leonprietobailo/DroneSTM32F405/doc/schemes.pptx

Batería

PDB

Sensores
(IMU, BMP280…)

Microcontrolador

ESCs

Motores

Receptor RC

## Slide 2

Inicialización

Instanciación variables globales

Inicialización software

Bucle principal

Cálculo referencia

Lectura y procesado sensores

Controladores

Actuadores

## Slide 3

Inicialización

Instanciación variables globales

Inicialización software

init_flash()

init_led()

Bucle principal

Cálculo referencia

Lectura y procesado sensores

Controladores

Actuadores

init_ultrasonic()

init_rc()

init_esc()

init_imu()

init_barometer()

## Slide 4

Inicialización

Instanciación variables globales

Inicialización software

Bucle principal

Cálculo referencia

Lectura y procesado sensores

Controladores

Actuadores

ref_mode_management()

ref_gen()

## Slide 5

Inicialización

Instanciación variables globales

Inicialización software

Bucle principal

Cálculo referencia

Lectura y procesado sensores

Controladores

Actuadores

read_battery()

read_rc()

red_imu()

process_imu()

read_barometer()

## Slide 6

Inicialización

Instanciación variables globales

Inicialización software

Bucle principal

Cálculo referencia

Lectura y procesado sensores

Controladores

Actuadores

cnt_attitude_sp()

cnt_attitude_pid()

cnt_altitude_pid()

## Slide 7

Inicialización

Instanciación variables globales

Inicialización software

Bucle principal

Cálculo referencia

Lectura y procesado sensores

Controladores

Actuadores

act_esc_outputs()

act_esc_pwm()

act_us_pulse()

## Slide 8

Espera

Espera

Espera

Solicitud y lectura

Espera

Lectura

Solicitud

Espera

## Slide 9

Duración ciclo > 4000 µs

Ejecución ciclo

Sí

No

## Slide 10

Stabilized

Disabled

Mounting

Altitude Hold
