leonprietobailo/DroneSTM32F405/SPI_flash/SdFat_print_file/SdFat_print_file.ino

// Adafruit SPI Flash FatFs Simple Datalogging Example
// Author: Tony DiCola
//
// This is a simple example that opens a file and prints its
// entire contents to the serial monitor.  Note that
// you MUST have a flash chip that's formatted with a flash
// filesystem before running, and there should be some sort
// of text file on it to open and read.  See the fatfs_format
// example to perform this formatting, and the fatfs_datalogging
// example to write a simple text file.
//
// Usage:
// - Modify the pins and type of fatfs object in the config
//   section below if necessary (usually not necessary).
// - Upload this sketch to your M0 express board.
// - Open the serial monitor at 115200 baud.  You should see the
//   example start to run and messages printed to the monitor.
//   If you don't see anything close the serial monitor, press
//   the board reset buttton, wait a few seconds, then open the
//   serial monitor again.

#include <SPI.h>
#include <SdFat.h>
#include <Adafruit_SPIFlash.h>

// for flashTransport definition
SPIClass SPI_FLASH(PIN_SPI3_MOSI, PIN_SPI3_MISO, PIN_SPI3_SCK, PIN_SPI3_SS);
Adafruit_FlashTransport_SPI flashTransport(PIN_SPI3_SS, &SPI_FLASH);

Adafruit_SPIFlash flash(&flashTransport);

// file system object from SdFat
FatVolume fatfs;

// Configuration for the file to open and read:
#define FILE_NAME      "data.csv"

void setup() {
  // Initialize serial port and wait for it to open before continuing.
  Serial.begin(115200);
  while (!Serial) {
    delay(100);
  }
  Serial.println("Adafruit SPI Flash FatFs Simple File Printing Example");

  // Initialize flash library and check its chip ID.
  if (!flash.begin()) {
    Serial.println("Error, failed to initialize flash chip!");
    while(1) delay(1);
  }
  Serial.print("Flash chip JEDEC ID: 0x"); Serial.println(flash.getJEDECID(), HEX);

  // First call begin to mount the filesystem.  Check that it returns true
  // to make sure the filesystem was mounted.
  if (!fatfs.begin(&flash)) {
    Serial.println("Error, failed to mount newly formatted filesystem!");
    Serial.println("Was the flash chip formatted with the fatfs_format example?");
    while(1) delay(1);
  }
  Serial.println("Mounted filesystem!");

  // Open the file for reading and check that it was successfully opened.
  // The FILE_READ mode will open the file for reading.
  File32 dataFile = fatfs.open(FILE_NAME, FILE_READ);
  if (dataFile) {
    // File was opened, now print out data character by character until at the
    // end of the file.
    Serial.println("Opened file, printing contents below:");
    while (dataFile.available()) {
      // Use the read function to read the next character.
      // You can alternatively use other functions like readUntil, readString, etc.
      // See the fatfs_full_usage example for more details.
      char c = dataFile.read();
      Serial.print(c);
    }
  }
  else {
    Serial.print("Failed to open file \"");
    Serial.print(FILE_NAME);
    Serial.print("\" !! Does it exist?");
  }
  Serial.println("done");
}

void loop() {
  // Nothing to do in main loop.
  delay(100);
}
