leonprietobailo/DroneSTM32F405/(commit log)

2022-07-23 [First Version] Template code from Joop Brokking downloaded from: http://www.brokking.net/ymfc-32_downloads.html To be adapted for the Feather STM32F405 chip.
2022-07-23 Modified XXXX_BASE with XXXX due to discrpancies between STM32F103C8T6 and STM32F405 definitions. Partly replaced HWire objects to Wire objects, this is because "Wire.h" now includes "HardWire.h" lib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
    TO BE CHECKED: Line 31 and 59 commented out of YMFC-32_Setup_ver-1a.ino, the imact of these changes has not been checked yet.
    [YMFC-32_Setup_ver-1a.ino, check_motor_vibrations.ino, input_capture_mode_handlers.ino, timer_setup.ino]
2022-08-04 Changed handlers and how interrupts are done in line with www.arduproject.es, performance to be checked. (timer_setup.ino, input_capture_mode_handlers.ino)
    Added PIN definition for Throttle, Yaw, Pitch and Roll. YMFC-32_Setup_ver-1a.ino
2022-09-12 gyro_setup.ino, read_gyro_data.ino: Modified HWire with Wire library
    input_capture_mode_handlers.ino: Modified handlers in line with YMFC-32_Setup_ver-1a/input_capture_mode_handlers.ino
    timer_setup.ino: Modified interrupts in line with YMFC-32_Setup_ver-1a/timer_setup.ino
    YMFC-32_Flight_Controller_ver-1a.ino: Added *hardcoded* calibrated radio values (check radioCallib/radioCallib.ino), added pins for radio commands.
2022-11-29 Added LED controls and general strength to the code in order to avoid drone getting crazy.
2022-11-30 Commented out timer_setup.ino lines corresponding with transmitter availability.
    Modified PID controller: YMFC-32_Flight_Controller_ver-1a.ino
2022-12-01 Modified read_gyro_data.ino to correct orrientation issues
    Modified radio calibration values on YMFC-32_Flight_Controller_ver-1a.ino
2022-12-05 Adjusted PID settings. Added proper commenting for troubleshooting.
2022-12-13 Added measure_distance.ino: this file computes distance using the ultrasonic sensor based on interrupts.
    Commented out error_signal.ino.
    Modified LED_control.ino: added fast and slow blinking LED and functions to turn on and off LED.
    YMFC-32_Flight_Controller_ver-1a.ino: modified LED functions in line with LED_control.ino changes. Added the corresponding setup and call of measure_distance.ino.
    [input_capture_mode_handlers.ino]
2022-12-14 measure_distance.ino: Added function for ultrasonic control. Added autolanding behaviour.
    YMFC-32_Flight_Controller_ver-1a.ino: added calls for measure_distance.ino functions
2022-12-16 measure_distance.ino: modified ultrasonic correction function
2022-12-23 timer_setup.ino: Was only being used for setup purposes, moved lines to YMFC-32_Flight_Controller_ver-1a.ino.
    measure_distance.ino: added ultrasonic correction functions (does not work atm), added velocity signal generation on echoPin_trigger()
    input_capture_mode_handlers.ino: commented out single channel interrupt handlers. Added read_PPM() which reads PPM signals (interrupt call). Added read_RC() which processes RC signals.
    YMFC-32_Flight_Controller_ver-1a.ino: Added SD card writing lines. Removed definitions for old RC pins, added the corresponding one for PPM. Added setup from timer_setup.ino and removed it's call. Modified all channel_x with the vectorised Mando_canal[x]. Added read_R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
    [input_capture_mode_handlers.ino, timer_setup.ino]
2022-12-27 input_capture_mode_handlers.ino: Renamed into read_rc.ino. Removed old comented handlers.
    process_rc.ino: Added new file for RC related commands.
    YMFC-32_Flight_Controller_ver-1a/YMFC-32_Flight_Controller_ver-1a.ino: Added acceleration related variables for auto-takeoff. Added call for newly added process_rc.ino function. Moved to process_rc.ino the RC related commands. Added new throttle computation (using takeoff throttle).
2022-12-27 process_rc.ino: Removed autonomous takeoff
    YMFC-32_Flight_Controller_ver-1a.ino: Reverted #Revision17 throttle computation.
2023-01-02 calculate_pid.ino: Added PID attitude control
    YMFC-32_Flight_Controller_ver-1a.ino: Added attitude control PID variables, added switch for throttle control. (UP: Normal control, DOWN: Attitude control)
2023-01-02 calculate_pid.ino: Splitted attitude control PIDs and altitude control PID.
    YMFC-32_Flight_Controller_ver-1a.ino: Modified hover lift hardcoded value. Added call to altitude_pid function.
2023-01-02 battery_control.ino: Added file to perform battery voltage computations and buzzer alarms.
    YMFC-32_Flight_Controller_ver-1a.ino: Added battery_control.ino initialisation.
2023-01-03 Added Joop Brokking code for STM32 - Auto.
2023-01-12 calculate_pid.ino: Added derivative outputs.
    YMFC-32_Flight_Controller_ver-1a/YMFC-32_Flight_Controller_ver-1a.ino: Added initializations, reduced reference hover throttle to 1450.
    process_gps.ino: Added GPS signal processing.
2023-01-15 calculate_pid.ino: Modified setpoint from 45 cm to 30 cm.
    YMFC-32_Flight_Controller_ver-1a.ino: Modified altitude hold PID variables, added integrator and derivator resets for altitude control PIDs.
2023-01-16 calculate_pid.ino: Added linearly increasing proportional gain.
    measure_distance.ino: Added filter for ultrasonic received measurements over 200 cm. (Not needed)
2023-01-16 calculate_pid.ino: Reverted to constant P gain.
    YMFC-32_Flight_Controller_ver-1a.ino: Tuned altitude hold controller, modified hover throttle value.
2023-01-18 battery_control.ino: Modified buzzer function.
    YMFC-32_Flight_Controller_ver-1a.ino: Added call to battery control fcn, modified how battery voltage is measured.
2023-01-18 battery_control.ino: Modified battery control values.
    YMFC-32_Flight_Controller_ver-1a.ino: Modified hover throttle.
2023-01-19 YMFC-32_Flight_Controller_ver-1a.ino: Removed yaw integrator. Added hover throttle computation to be battery voltage dependant.
2023-01-19 YMFC-32_Flight_Controller_ver-1a.ino: Modified hover throttle value, modified P gain for altitude control.
2023-01-19 calculate_pid.ino: modified setpoint, modified increasing p gain.
    YMFC-32_Flight_Controller_ver-1a.ino: modified hover throttle, modified altitude control pid
2023-01-30 Added SPI_flash files for formatting and reading on-board flash memory.
    battery_control.ino: Commented out buzzer sound when low battery is detected.
    calculate_pid.ino: Modified reference altitude, removed increasing proportional gain.
    calibrate_gyro.ino: Added acceleration calibration.
    read_gyro_data.ino: Modified calibration values, added acc_z callibration.
    YMFC-32_Flight_Controller_ver-1a.ino: Added flash storage varaibles for data recording. Added variables for acc calibration, added hover throttle, added flash_setup() call, added flash_write() call.
    compute_hover_throttle.ino: Added compute_hover_throttle.ino function.
    flash_write.ino: Added on.board flash setup and writing.
    [SdFat_print_file.ino, example.ino, format.ino, read.ino]
2023-02-12 calculate_pid.ino: Added integrators again, only triggered when distance is greater than 15 cm, to avoid OL integrator errors.
    measure_distance.ino: Removed complementary filter since it was driving reaction slowness to the drone.
    YMFC-32_Flight_Controller_ver-1a.ino: Removed radio dead bands. Modified origin hoverThrottle. Added variables for integrators and modified PID parameters.
2023-03-20 calculate_pid.ino: Added self adjusting throttle using P controller. ATM. Have not performed any tests.
    Added self adjusting throttle variable declaration + calls.
    Added empty files to change software architecture:
    actuators.ino: Must contain ESCs related computations. E.g.: PWMs...
    controllers.ino: Must contain controller related computations. E.g.: Attitude controllers, altitude hold controller... Will also contain control error computations (probably).
    measurement_processing.ino: Must contain sensor signal related computations: E.g.: Computing current angle, rate...
    reference_computation.ino: Must contain references generated used for PIDs. E.g.: Radio based references, altitude hold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
2023-03-25 Added MS5611/MS5611_base/MS5611_base which contains a working and clean pressure signal obtained from MS5611 sensor ready to be fed to altitude hold controllers.
    Added i2c_scanner/i2c_scanner file which allows address scan for i2c protocols.
    Next step is to implement the sensor to the quadcopter, add the control algorithm and perform adjustments.
2023-03-27 [MAJOR UPDATE]: Changed whole program architecture.
    Now the control algorithm works with the following files:
    actuators.ino: Everything related to actuators: ESCs, ultrasonic...
    controllers.ino: PIDs. In general.
    measurement_processing: Everything related to processing sensor signals.
    read_units: Everything related to sensor readouts.
    Added diganostics.ino file, which provides with useful information regarding diagnostics, this includes buzzer, LEDs or Serial commands.
    Added initialization.ino file, which contain everything related to setup.
    Added z folder which contains tbd and deprecated files.
    [actuators.ino, barometer.ino, controllers.ino, diagnostics.ino, main_YMFC.ino, z_tbd_process_gps.ino]
2023-03-29 Removed self adjusting altitude control throttle.
    Disabled attitude control integrators for small distances.
2023-03-29 LowPass.h: Digital low-pass filter implemented from https://github.com/curiores/ArduinoTutorials/blob/main/BasicFilters/ArduinoImplementations/LowPass/LowPass2.0/LowPass2.0.ino
    actuators.ino: Modified how self adjusting throttle is computed in order to make possible on-air flight mode changes.
    controllers.ino: Modified references, and added new alt_hold_pid following the schematic used for ArduPilot: https://ardupilot.org/copter/docs/altholdmode.html
    main_YMFC.ino: Added required variables in line with latest PID addition.
    read_units.ino: Generated filtered signals in order to perform accurate control.
2023-04-01 controllers.ino: Modified altitude hold controller.
    main_YMFC.ino / read_units.ino: Added new velocity computations + initialization variables.
    BMP280.ino: Generated signal computation, with temperature and pressure corrections. This uses LowPass.h which provides with digital low pass filtering.
    [BMP280.ino, controllers.ino, diagnostics.ino, main_YMFC.ino]
2023-04-02 General code formatting.
    BMP280: Added parachute throttle which is used for long term altitude change for the derivator.
    Added BMP280 signal processing to main-YMFC.
2023-04-04 [MAIN CHANGE/s] Added barometer sensor to the project. This added extra delay in some iterations of the main loop, therefore, some optimizations had to be done.
    Micro controller timers were added to the code in order to generate PWM signals. This saves around 1800 us / loop iteration.
    actuators.ino: Recovered hover throttle for pressure altitude control. Added timers to ESCs control.
    controllers.ino: Modified barometer controller.
    main_YMFC: Added generation of timers to the code.
    Added timer examples.
2023-04-04 actuators.ino: Modified the way the duty cycle was being modified with ESCs outputs. Added call to the new esc_PWM fcn.
    initialization.ino: Modified ESCs initialization with timers.
    main: Modified timers initialization. On previous release, the same timer was being initialized multiple times.
    measurement_processing.ino: Modified range of stick combinations to make it wider.
    timer_example_v2/timer_example_v2.ino: Modified test file in line with the current timer configuration.
2023-04-06 actuators.ino: Modified the sign PID output was being added to hover throttle.
    controllers.ino / read_units.ino: Now, altitude hold controller is called when barometer measurements are available and not every loop cycle.
    main_YMFC.ino: Initialzied pressure value with standar pressure at seal level, in order to make the complementary filter convergence before. Modified altitude hold PID values.
2023-04-06 [FIRST SUCCESSFUL ALTITUDE HOLD FLIGHT]
    actuators.ino: Modified the sign PID output was being added to hover throttle.
    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
2023-04-06 Added enumeration for FlightMode management, removed old "Start" variable.
    actuators.ino: Removed old selector for altitude hold and stabilized modes. Changed ESCs computation in order to fit the corresponding modes.
    reference_computation.ino: Added two core functions ref_set_mode() and ref_gen().
    - ref_set_mode(): This function changes the drone flight model depending on radio inputs.
    - ref_gen(): This generates reference parameters which are dependent on the flight mode
    Additional functions computing set points should be added to this file.
    measurement_processing.ino: Removed process_rc(), function is now migrated to reference_computation.ino
    [actuators.ino, diagnostics.ino, main_YMFC.ino, reference_computation.ino]
2023-06-11 controllers.ino: Added call to barometer PID, based on barometer_counter for execution. initialization.ino: Replaced hard-coded MPU6050 addresses with #defined variables. main_YMFC.ino: Added #define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
    [C]
    [controllers.ino, main_YMFC.ino, reference_computation.ino]
2023-06-11 actuators.ino: Renamed and sorted core functions. controllers.ino: Renamed and sorted core functions. Removed unused functions.
    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
2023-10-08 he subido un documento de texto con una intro
2023-10-08 Revert "he subido un documento de texto con una intro"
    This reverts commit 04519f233c23fe3539efe945c433157dba3f7cc6.
